wereallgeek/C64-ShiftIRQ-LED/(list of files, drawings)

Other design files:
temp-freerouting.dsn
