wereallgeek/C64-ShiftIRQ-LED/C64 IRQ LED.kicad_pcb

## KiCad design C64 IRQ LED.kicad_pcb (2026-10-12)

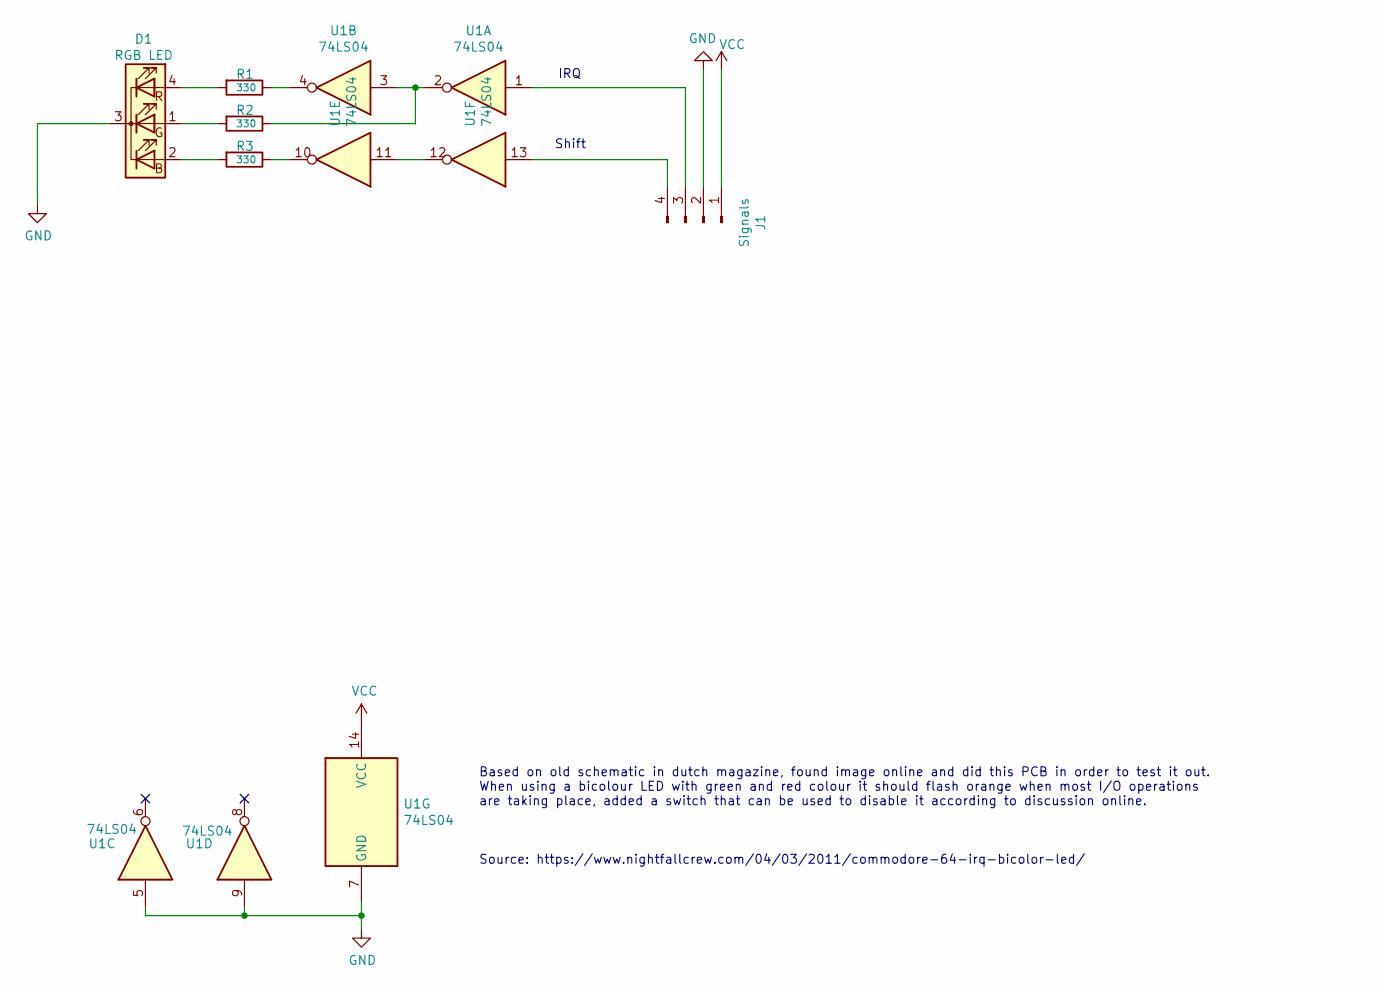
[picture p5: schematic C64 IRQ LED.kicad_sch, C64 Shift+IRQ LED]

Parts:
D1: RGB LED; LED_D5.0mm-4_RGB
J1: Signals; PinHeader_1x04_P2.54mm_Horizontal
R1, R2, R3: 330; R_Axial_DIN0207_L6.3mm_D2.5mm_P7.62mm_Horizontal
U1: 74LS04; DIP-14_W7.62mm_LongPads

Connections:
GND: D1.3 (K), J1.2, U1.5, U1.7 (GND), U1.9
unnamed: D1.2 (BA), R3.2
unnamed: D1.1 (GA), R2.2
unnamed: D1.4 (RA), R1.2
unnamed: J1.3, U1.1
unnamed: J1.4, U1.13
unnamed: R1.1, U1.4
unnamed: R2.1, U1.2, U1.3
unnamed: R3.1, U1.10
unnamed: U1.11, U1.12
VCC: J1.1, U1.14 (VCC)

Notes on the sheet:
Based on old schematic in dutch magazine, found image online and did this PCB in order to test it out. When using a bicolour LED with green and red colour it should flash orange when most I/O operations are taking place, added a switch that can be used to disable it according to discussion online.
Source: https://www.nightfallcrew.com/04/03/2011/commodore-64-irq-bicolor-led/
IRQ
Shift

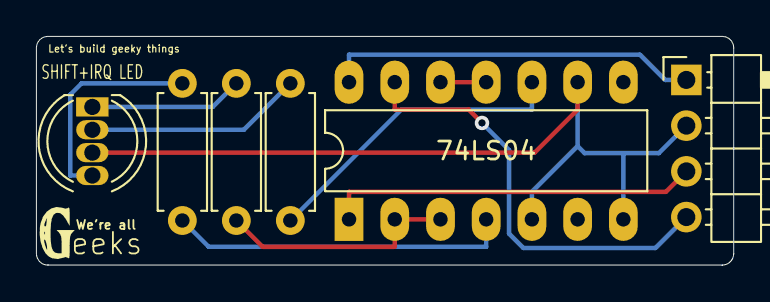
[picture p6: board C64 IRQ LED.kicad_pcb from above]

Board: 2 copper layers, 38.7 x 12.7 mm, 6 parts (0 on the bottom side), 11 nets.
