wereallgeek/C64-ShiftIRQ-LED/(commit log)

2026-08-24 Initial version of the Shift+IRQ LED MOD
    adding Shift to the IRQ LED Mod
    [C64 IRQ LED.kicad_pcb, C64 IRQ LED.kicad_sch, temp-freerouting.dsn]
2026-10-12 removed connectors from BOM
    [C64 IRQ LED.kicad_pcb, C64 IRQ LED.kicad_sch]
2026-10-13 README.md updates
    Changes to the procedure. Will need to alter the photos, replace TEBL's by mine, talk about the Mechboard wiring, etc, etc, etc.
2026-11-06 Update PCB fabrication instructions in README
2026-11-06 Update PCB ordering link format in README
