wereallgeek/C64-ShiftIRQ-LED/(notices)

Notices in the files:
C64 IRQ LED.kicad_pcb:
Licensed under CERN-OHL-S v2
